brittinator/OhMyBeats---Ada-Capstone/Images/construction/blend.jpg

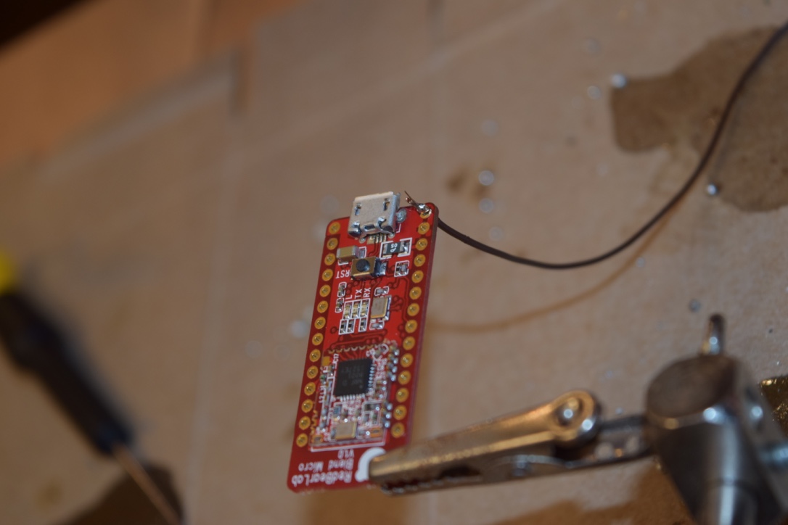
Images/construction/blend.jpg
