brittinator/OhMyBeats---Ada-Capstone/Images/construction/hatnotlit.jpg

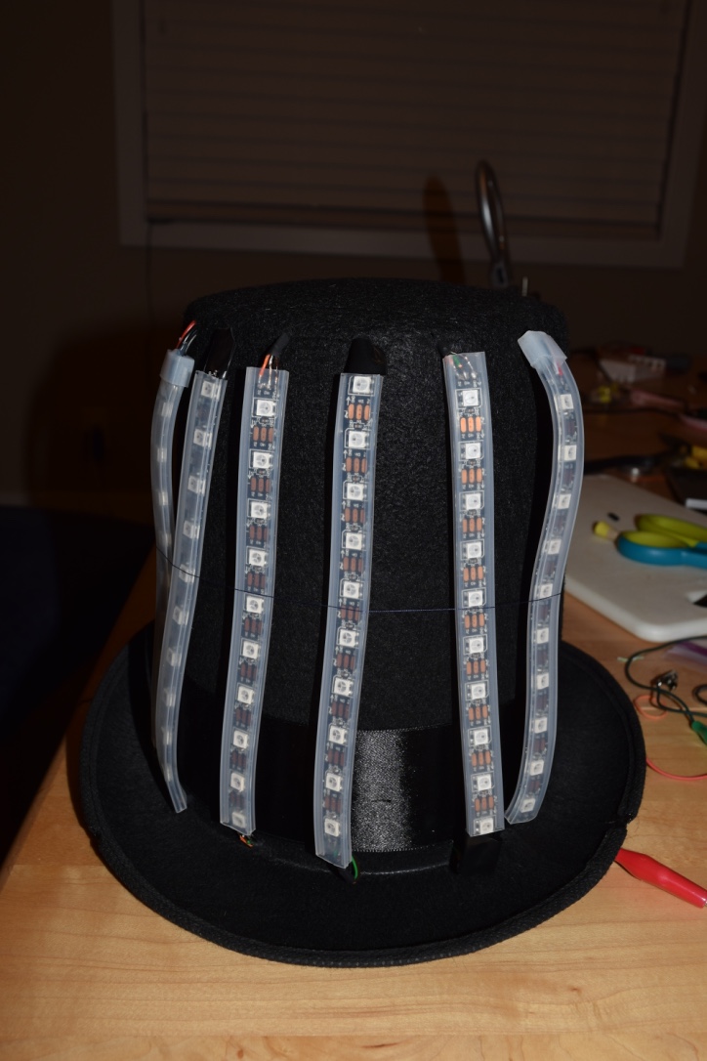
Images/construction/hatnotlit.jpg
