brittinator/OhMyBeats---Ada-Capstone/Images/construction/snakewire.jpg

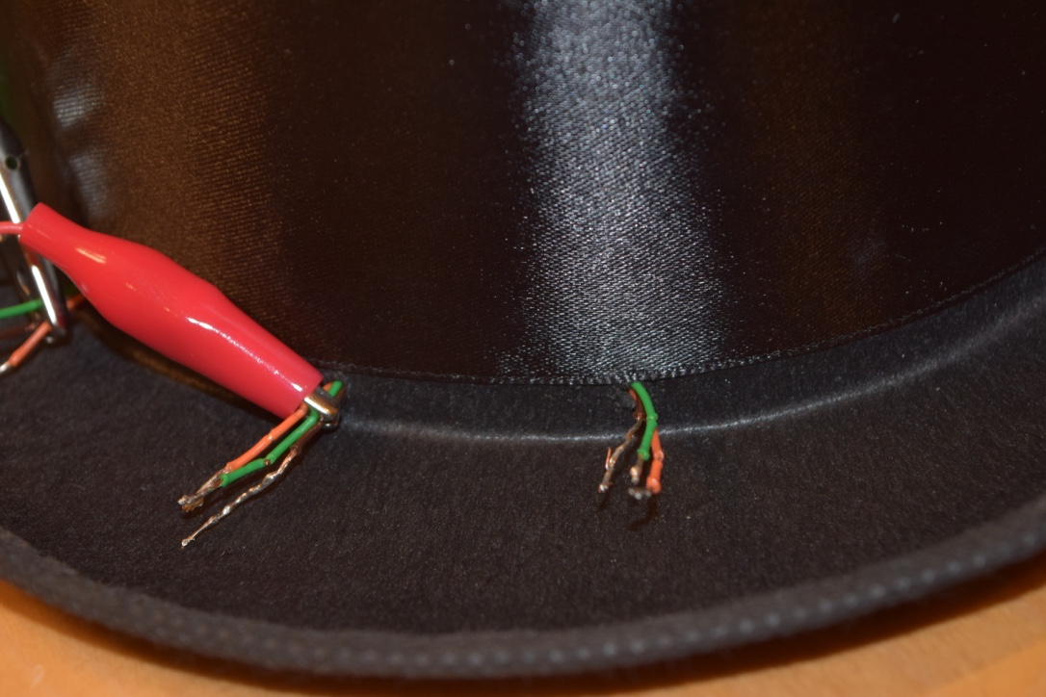
Images/construction/snakewire.jpg
