brittinator/OhMyBeats---Ada-Capstone/Images/construction/wiring.png

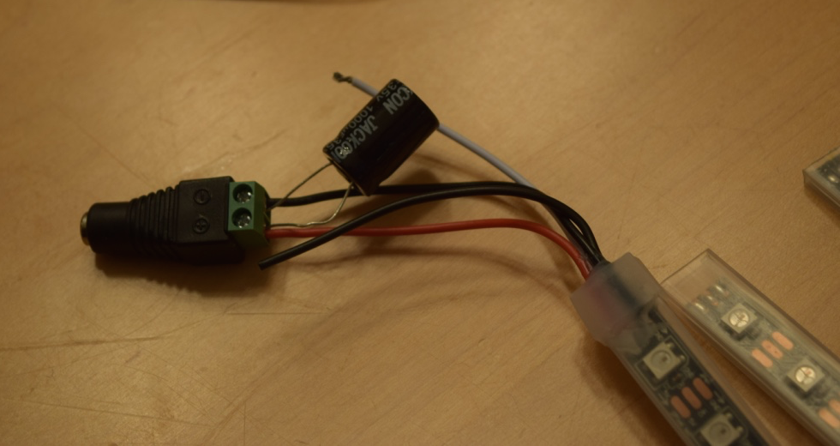
Images/construction/wiring.png
