brittinator/OhMyBeats---Ada-Capstone/(commit log)

2015-10-19 First crack at programming lights into 6 buckets of sound frequencies.
2015-10-23 First commit, adds python script rough draft for performing fft and sending array data to Arduino via a serial connection (USB). WIP: Timing lights to length of the song.
2015-10-23 Removes obsolete arduino code.
2015-10-23 Arduino code for lighting up LEDs via serial communication. WIP: timing lights to music.
2015-10-23 Adds image foldes - caution and schematic pictures.
2015-10-25 Fixed the timing issue/git st
    [musicFourierTransform.py]
2015-10-25 WIP: snaking the LEDs to match upright position after soldering them together. Also, WIP for refactoring code quality.
2015-10-25 Adds right orientation for equalizer buckets after soldering in a snake-pattern.
2015-10-25 All frequency buckets working properly except first bracket (because of the missing first LED is throwing the math off).
    [musicalLeds.ino]
2015-10-26 Adds Python and Arduino code (current as of today 10-26). WIP: adds details to constructing the hat.
2015-10-28 Adds light fading feature, and reworks loops for added (supposed) simplicity.
    [musicalLeds.ino]
2015-10-29 Check to turn off LEDs messes with the syncing of the lights to stop moving to the end of the song.
2015-10-29 Adds wire stripper to supply list.
2015-10-29 Adds assembly images.
2016-03-02 Adding process flow diagram.
